mihtjel/iv-grapher/README.md

# iv-grapher
IV graphing electronics project. KiCAD design and Python (PyQT) based software.
