mihtjel/iv-grapher/hardware/DG306.model/dg306-2.FCStd

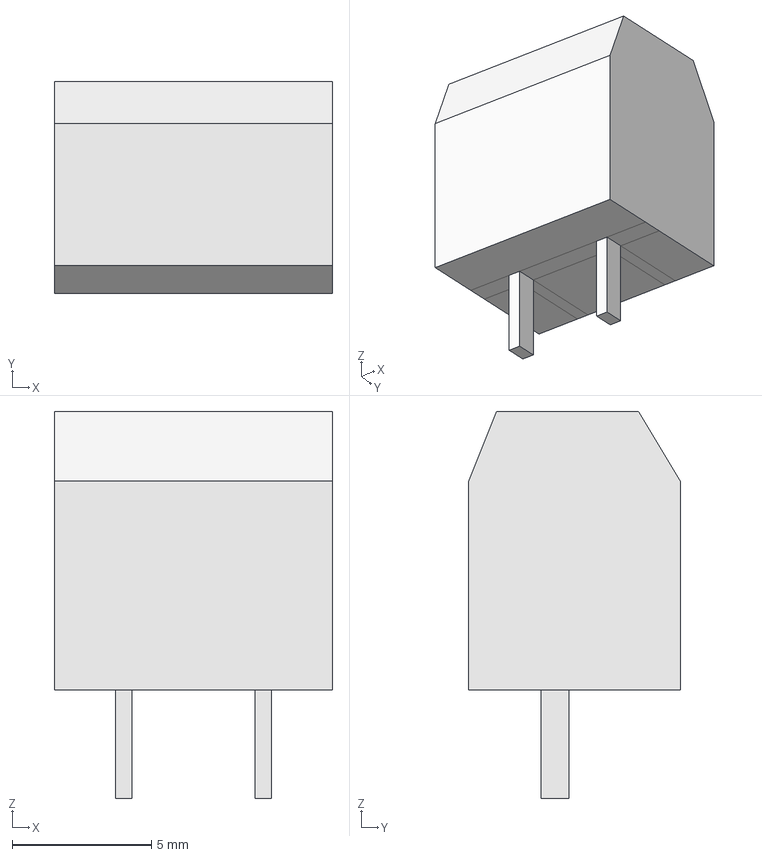
[picture p1: CAD file, 2017-03-31]
hardware/DG306.model/dg306-2.FCStd
10.0 x 7.60 x 13.9 mm
