mihtjel/iv-grapher/(list of files, cad)

Other CAD files:
hardware/DG306.model/dg306.FCStd
hardware/DG306.model/dg306-2.stl
