mihtjel/iv-grapher/hardware/iv-grapher.kicad_pcb

## KiCad design hardware/iv-grapher.kicad_pcb (2017-03-31)

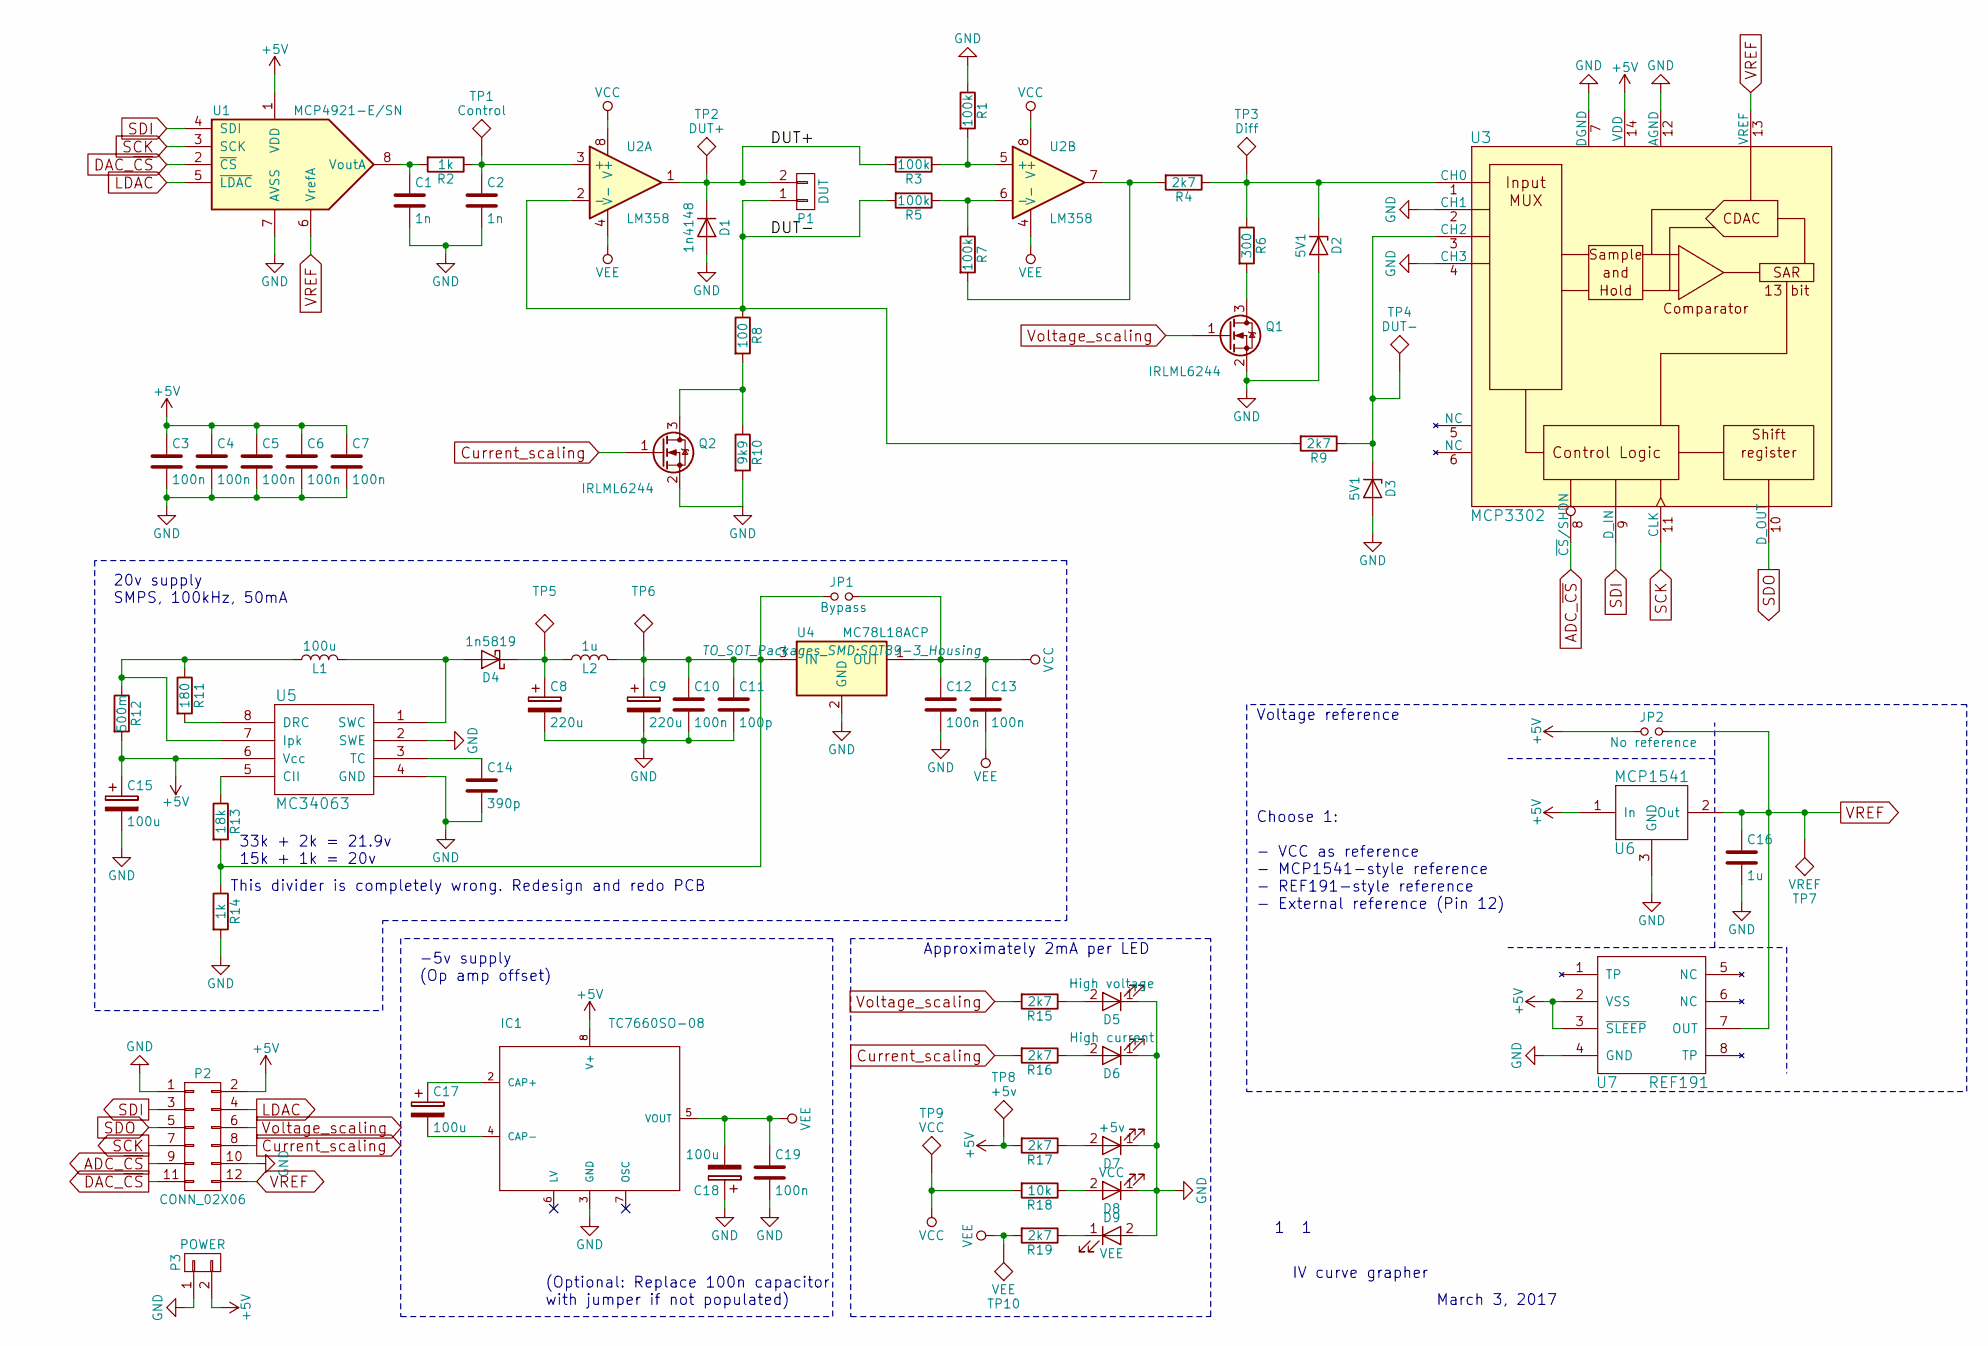
[picture p2: schematic iv-grapher.sch]

Parts:
C1, C2: 1n; C_0805
C3, C4, C5, C6, C7, C10, C12, C13, C19: 100n; C_0805
C8, C9: 220u; C_Radial_D8_L11.5_P3.5
C11: 100p; C_0805
C14: 390p; C_0805
C15, C17, C18: 100u; C_Radial_D6.3_L11.2_P2.5
C16: 1u; C_0805
D1: 1n4148; R_0805
D2, D3: 5V1; SOD-123
D4: 1n5819; SOD-123
D5: High voltage; R_0805
D6: High current; R_0805
D7: +5v; R_0805
D8: VCC; R_0805
D9: VEE; R_0805
IC1: TC7660SO-08; SOIC-8_3.9x4.9mm_Pitch1.27mm
JP1: Bypass; R_0805
JP2: No reference; R_0805
L1: 100u; Choke_SMD_6.3x6.3_H3
L2: 1u; R_0805
P1: DUT; DG306-5.0_2-pin
P2: CONN_02X06; IDC_Header_Straight_12pins
P3: POWER; Pin_Header_Straight_1x02
Q1, Q2: IRLML6244; SOT-23
R1, R3, R5, R7: 100k; R_0805
R2, R14: 1k; R_0805
R4, R9, R15, R16, R17, R19: 2k7; R_0805
R6: 300; R_0805
R8: 100; R_0805
R10: 9k9; R_0805
R11: 180; R_0805
R12: 500m; R_0805
R13: 18k; R_0805
R18: 10k; R_0805
TP1: Control; Measurement_Point_Round-SMD-Pad_Small
TP2: DUT+; Measurement_Point_Round-SMD-Pad_Small
TP3: Diff; Measurement_Point_Round-SMD-Pad_Small
TP4: DUT-; Measurement_Point_Round-SMD-Pad_Small
TP5: VCC pre filter; Measurement_Point_Round-SMD-Pad_Small
TP6: VCC post filter; Measurement_Point_Round-SMD-Pad_Small
TP7: VREF; Measurement_Point_Round-SMD-Pad_Small
TP8: +5v; Measurement_Point_Round-SMD-Pad_Small
TP9: VCC; Measurement_Point_Round-SMD-Pad_Small
TP10: VEE; Measurement_Point_Round-SMD-Pad_Small
U1: MCP4921-E/SN; SOIC-8_3.9x4.9mm_Pitch1.27mm
U2: LM358; SOIC-8_3.9x4.9mm_Pitch1.27mm
U3: MCP3302; SOIC-14_3.9x8.7mm_Pitch1.27mm
U4: MC78L18ACP; SOT89-3_Housing
U5: MC34063; SOIC-8_3.9x4.9mm_Pitch1.27mm
U6: MCP1541; SOT-23
U7: REF191; SOIC-8_3.9x4.9mm_Pitch1.27mm

Connections:
+5V: C3.1, C4.1, C5.1, C6.1, C7.1, C15.1, IC1.8 (V+), JP2.1, P2.2, P3.2, R12.2, R17.2, TP8.1, U1.1 (VDD), U3.14 (VDD), U5.6 (Vcc), U6.1 (In), U7.2 (VSS), U7.3 (~SLEEP)
/DUT+: D1.1 (K), P1.2, R3.2, TP2.1, U2.1
/DUT-: P1.1, R5.2, R8.1, R9.2, U2.2 (-)
ADC_~CS: P2.9, U3.8 (~CS~/SHDN)
Current_scaling: P2.8, Q2.1 (G), R16.2
DAC_~CS: P2.11, U1.2 (~CS~)
GND: C1.2, C2.2, C3.2, C4.2, C5.2, C6.2, C7.2, C8.2, C9.2, C10.2, C11.2, C12.2, C14.2, C15.2, C16.2, C18.1, C19.2, D1.2 (A), D2.2 (A), D3.2 (A), D5.1 (K), D6.1 (K), D7.1 (K), D8.1 (K), D9.2 (A), IC1.3 (GND), P2.1, P2.10, P3.1, Q1.2 (S), Q2.2 (S), R1.1, R10.2, R14.2, U1.7 (AVSS), U3.2 (CH1), U3.4 (CH3), U3.7 (DGND), U3.12 (AGND), U4.2 (GND), U5.2 (SWE), U5.4 (GND), U6.3 (GND), U7.4 (GND)
LDAC: P2.4, U1.5 (~LDAC~)
unnamed: C1.1, R2.2, U1.8 (VoutA)
unnamed: C2.1, R2.1, TP1.1, U2.3 (+)
unnamed: C8.1, D4.1 (K), L2.1, TP5.1
unnamed: C9.1, C10.1, C11.1, JP1.1, L2.2, R13.2, R14.1, TP6.1, U4.3 (IN)
unnamed: C14.1, U5.3 (TC)
unnamed: C17.1, IC1.2 (CAP+)
unnamed: C17.2, IC1.4 (CAP-)
unnamed: D2.1 (K), R4.1, R6.1, TP3.1, U3.1 (CH0)
unnamed: D3.1 (K), R9.1, TP4.1, U3.3 (CH2)
unnamed: D4.2 (A), L1.2, U5.1 (SWC)
unnamed: D5.2 (A), R15.1
unnamed: D6.2 (A), R16.1
unnamed: D7.2 (A), R17.1
unnamed: D8.2 (A), R18.1
unnamed: D9.1 (K), R19.1
unnamed: L1.1, R11.1, R12.1, U5.7 (Ipk)
unnamed: Q1.3 (D), R6.2
unnamed: Q2.3 (D), R8.2, R10.1
unnamed: R1.2, R3.1, U2.5 (+)
unnamed: R4.2, R7.2, U2.7
unnamed: R5.1, R7.1, U2.6 (-)
unnamed: R11.2, U5.8 (DRC)
unnamed: R13.1, U5.5 (CII)
SCK: P2.7, U1.3 (SCK), U3.11 (CLK)
SDI: P2.3, U1.4 (SDI), U3.9 (D_IN)
SDO: P2.5, U3.10 (D_OUT)
VCC: C12.1, C13.1, JP1.2, R18.2, TP9.1, U2.8 (V+), U4.1 (OUT)
VEE: C13.2, C18.2, C19.1, IC1.5 (VOUT), R19.2, TP10.1, U2.4 (V-)
VREF: C16.1, JP2.2, P2.12, TP7.1, U1.6 (VrefA), U3.13 (VREF), U6.2 (Out), U7.7 (OUT)
Voltage_scaling: P2.6, Q1.1 (G), R15.2

Notes on the sheet:
33k + 2k = 21.9v 15k + 1k = 20v
Approximately 2mA per LED
-5v supply (Op amp offset)
(Optional: Replace 100n capacitor with jumper if not populated)
Voltage reference
Choose 1: - VCC as reference - MCP1541-style reference - REF191-style reference - External reference (Pin 12)
20v supply SMPS, 100kHz, 50mA
IV curve grapher
March 3, 2017
This divider is completely wrong. Redesign and redo PCB

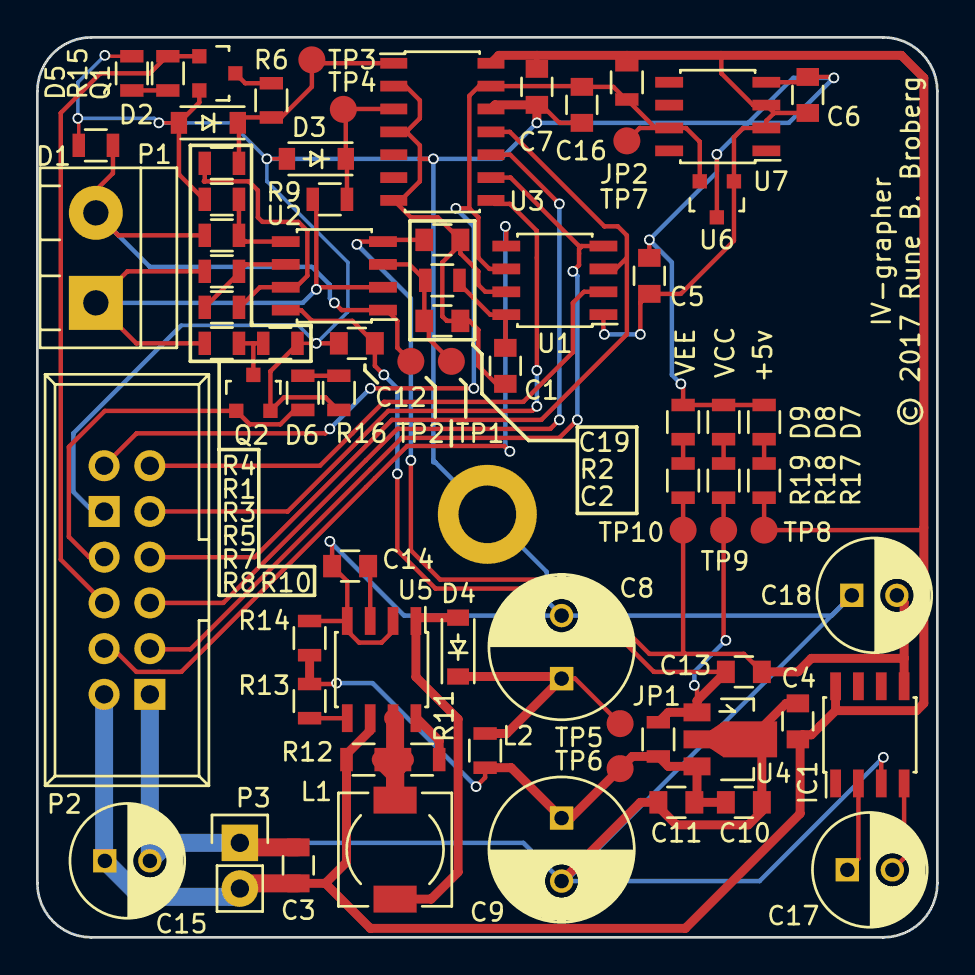
[picture p3: board iv-grapher.kicad_pcb from above]

Board: 2 copper layers, 50.0 x 50.0 mm, 74 parts (0 on the bottom side), 38 nets.
