mihtjel/iv-grapher/(commit log)

2017-03-26 Arduino control software
2017-03-26 Moved to fit Arduino software quirks
2017-03-26 Moved to fit Arduino quirks
2017-03-26 High voltage and high current options added.
2017-03-26 Layout improvements High/low voltage and current working Progress bar for sweeps
2017-03-28 Error dialog added. Locking for the serial port, to avoid simultaneous writes.
    [iv-grapher.py]
2017-03-28 Static calibration (+2mV from the ADC reading for the sample. Needs further testing.) Sweep bugfix
    [iv-grapher.py]
2017-03-31 Added KiCAD project
    [dg306-2.FCStd, dg306-2.stl, dg306.FCStd, iv-grapher.kicad_pcb, iv-grapher.sch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]
2017-04-01 - Multiple sweeps in one window, - Option of having a new sweep window, - Labels on sweeps, - Current correction from diff. amp. leakage, - Zero-current button, - Progress bar resets after a stopped 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
    [iv-grapher.py]
2017-04-01 - Min/max shading - Automatic ranging of sweep values - Minor fix of progress bar when starting/stopping sweeps
    [iv-grapher.py]
2017-04-09 - Set static calibration to 0
2017-04-09 Start of design version 2
    [iv-grapher.sch]
