mihtjel/iv-grapher/(notices)

Notices in the files:
hardware/iv-grapher.kicad_pcb:
© 2017 Rune B. Broberg
